dreadnomad/FGCCS-Ctrl22/README.md

# FGCCS-Ctrl22
Atmega4808-based charge controller for electric vehicles.
Inspired by SmartEVSE.
