dreadnomad/FGCCS-Ctrl22/doc/APPNOTES.md

# Useful Application Notes for ATmega4808 Development

All Application Notes for ATmega4808 available at:
https://www.microchip.com/wwwproducts/en/ATMEGA4808 -> Documents

- AN1982 Interrupt System
- AN8108 Temperature Sensor Calibration
- AN2751 Process Scheduling
- TB3209 Getting Started with ADC
- TB3217 Getting Started with TCA
- TB3214 Getting Started with TCB
- TB3217 Getting Started with USART
