dreadnomad/FGCCS-Ctrl22/circuit/parts_mouser.pdf

ATMEVSE
Mouser-Nr. | Herst.- Nr. | Hersteller Beschreibung | Stückzahl Preis (EUR) Gesamtpreis: (EUR)
926-LM7332MA/NOPB LM7332MA/NOPB | Texas Instruments Operationsverstärker DUAL RRIO OP AMP | 5 | 2,53 € | 12,65 €
579-TC7660SEOA | TC7660SEOA | Microchip Schaltspannungsregler High Voltage | 5 | 0,81 € | 4,05 €
595-SN65HVD72D | SN65HVD72D | Texas Instruments RS-485-IC-Schnittstelle 3.3V-Supply RS-485 | 5 | 2,50 € | 12,50 €
512-FAN3214TMX | FAN3214TMX | ON Semiconductor Gate-Treiber Dual 4A High-Speed LowSide Gate-Treiber | 5 | 1,06 € | 5,30 €
769-AQH1213AX | AQH1213AX | Panasonic Halbleiterrelais - PCB-Montage AC 600 V Zero Cross 0.6A SMD | 15 | 1,32 € | 19,80 €
621-AP5100WG-7 | AP5100WG-7 | Diodes Incorporated Schaltspannungsregler 1.2A Step-Down Conv 1.4MHz Sw Freq | 5 | 0,89 € | 4,46 €
849-CPC1114N | CPC1114N | IXYS | Halbleiterrelais - PCB-Montage SP, Normally-Closed OptoMOS Relay 10 | 0,95 € | 9,54 €
594-MCT06030C3309FP5MCT06030C3309FP500 Vishay | Dünnfilmwiderstände - SMD .1W 33ohm 1% 0603 50ppm Auto | 10 | 0,21 € | 2,07 €
594-MCT06030C2209FP5MCT06030C2209FP500 Vishay | Dünnfilmwiderstände - SMD .1W 22ohm 1% 0603 50ppm Auto | 30 | 0,21 € | 6,21 €
594-MCT06030C1202FP5MCT06030C1202FP500 Vishay | Dünnfilmwiderstände - SMD .1W 12Kohm 1% 0603 50ppm Auto | 10 | 0,14 € | 1,44 €
594-MCT06030C1001FP5MCT06030C1001FP500 Vishay | Dünnfilmwiderstände - SMD .1W 1Kohm 1% 0603 50ppm Auto | 20 | 0,09 € | 1,80 €
594-MCT06030C1502FP5MCT06030C1502FP500 Vishay | Dünnfilmwiderstände - SMD .1W 15Kohm 1% 0603 50ppm Auto | 40 | 0,14 € | 5,76 €
594-MCT06030C2001FP5MCT06030C2001FP500 Vishay | Dünnfilmwiderstände - SMD .1W 2Kohm 1% 0603 50ppm Auto | 20 | 0,14 € | 2,88 €
594-MCT06030C1003FP5MCT06030C1003FP500 Vishay | Dünnfilmwiderstände - SMD .1W 100Kohm 1% 0603 50ppm Auto | 10 | 0,13 € | 1,25 €
594-MCT06030C4022FP5MCT06030C4022FP500 Vishay | Dünnfilmwiderstände - SMD .1W 40.2Kohms 1% 0603 50ppm Auto | 10 | 0,09 € | 0,90 €
594-MCT06030C1000FP5MCT06030C1000FP500 Vishay | Dünnfilmwiderstände - SMD .1W 100ohm 1% 0603 50ppm Auto | 110 | 0,05 € | 5,94 €
594-MCT06030C1002FP5MCT06030C1002FP500 Vishay | Dünnfilmwiderstände - SMD .1W 10Kohms 1% 0603 50ppm Auto | 70 | 0,10 € | 6,93 €
594-MCT06030C3162FP5MCT06030C3162FP500 Vishay | Dünnfilmwiderstände - SMD .1W 31.6Kohms 1% 0603 50ppm | 20 | 0,14 € | 2,70 €
512-BSS138 | BSS138 | ON Semiconductor MOSFET SOT-23 N-CH LOGIC | 10 | 0,16 € | 1,61 €
810-MLF1608A3R3J | MLF1608A3R3J | TDK | Festinduktivitäten 0603 3.3uH 5% | 10 | 0,15 € | 1,48 €
710-61304011121 | 61304011121 | Wurth Elektronik Sockel & Kabelgehäuse WR-PHD 2.54mm Hdr 40P Single Str Gold | 2 | 1,31 € | 2,62 €
710-61300821121 | 61300821121 | Wurth Elektronik Sockel & Kabelgehäuse WR-PHD 2.54mm Hdr 8P Dual Str Gold | 20 | 0,50 € | 9,96 €
871-B72214S0271K551 B72214S0271K551 | EPCOS / TDKVaristoren 275VAC 10% 14mm StandarD | 15 | 0,46 € | 6,92 €
576-3921125000 | 39211250000 | Littelfuse Sicherungen mit Anschlüssen (Durchsteckmontage) 250V IEC TL LL 1.25A TE5 10 | 0,59 € | 5,89 €
576-1812L020PR | 1812L020PR | Littelfuse Rückstellbare Sicherungen - PPTC 30V 1812 .200A POLYFUSE | 10 | 0,33 € | 3,29 €
771-PMEG4010BEA,135PMEG4010BEA,135 | Nexperia Schottky Dioden & Gleichrichter 1A Very Low VF MEGA Barrier Rectifier5 | 0,32 € | 1,58 €

583-BAT54S | BAT54S | Rectron Schottky Dioden & Gleichrichter SOT23 0.2A 30V Schot tky Dblr | 25 | 0,08 € | 1,90 €
652-SMAJ13CA | SMAJ13CA | Bourns | ESD-Entstörer/TVS-Dioden 13volts 5uA 18.6 Amps Bi-Dir | 10 | 0,26 € | 2,63 €
833-MMXZ5226B-TP | MMXZ5226B-TP | Micro Commercial Components (MCC) Zener-Dioden 200mW 3.3V | 10 | 0,17 € | 1,67 €
963-EMK212ABJ106MG-TEMK212ABJ106MG-T | Taiyo YudenKondensator aus mehreren Keramikschichten MLCC - SMD/SMT 0805 16VDC 10uF 20% X5R 80 | 0,12 € | 9,44 €
963-EMF212B7104KGHTEMF212B7104KGHT | Taiyo YudenKondensator aus mehreren Keramikschichten MLCC - SMD/SMT 0805 16V 0.1uF 10% AEC-Q200 120 | 0,06 € | 7,32 €
77-VJ0805A271KXJPBC VJ0805A271KXJPW1BC Vishay | Kondensator aus mehreren Keramikschichten MLCC - SMD/SMT 0805 270pF 16volts C0G 10% 10 | 0,20 € | 1,98 €
77-VJ0805A102KXAAC VJ0805A102KXAAC | Vishay | Kondensator aus mehreren Keramikschichten MLCC - SMD/SMT 1000pF 50volts C0G 10% 10 | 0,09 € | 0,90 €
77-VJ805Y105KXARW1BCVJ0805Y105KXARW1BC Vishay | Kondensator aus mehreren Keramikschichten MLCC - SMD/SMT FACTORY NOT ACCEPTING ORDERS 10 | 0,27 € | 2,70 €
77-VJ0805Y101KXACBC VJ0805Y101KXACW1BC Vishay | Kondensator aus mehreren Keramikschichten MLCC - SMD/SMT 0805 100pF 50volts X7R 10% 10 | 0,22 € | 2,16 €
871-B41231A4109M000B41231A4109M000 | EPCOS / TDKAlu-Elektrolytkondensatoren - einrastend 16VDC 10000uF 20% PVC 6mm Terminals 10 | 1,04 € | 10,40 €
709-IRM10-12 | IRM-10-12 | MEAN WELLAC/DC-Leistungsmodule 12V 0.85A 10.2W 85-264Vin Encap PS | 5 | 7,70 € | 38,50 €
490-TB005-762-10BE TB005-762-10BE | CUI DevicesFeste Anschlussblöcke Terminal block, screw type, 7.62 , horizontal, 10 poles, CUI Blue, slotted screw, PCB mount 10 | 1,55 € | 15,50 €
490-TB004-508-18BE TB004-508-18BE | CUI DevicesFeste Anschlussblöcke Terminal block, screw type, 5.08 , horizontal, 18 poles, CUI Blue, slotted screw, PCB mount 10 | 1,68 € | 16,80 €
581-TLCR107M006RTA TLCR107M006RTA | AVX | Tantalkondensatoren - fest für SMD 6.3V 100uF 20% | 10 | 1,94 € | 19,40 €
| | | | | TOTAL: | 270,82 €
