dreadnomad/FGCCS-Ctrl22/circuit/FGCCS-Ctrl22-Materialstueckliste.xls

FGCCS-CTRL22-REV1.1
Materialstückliste
Herst.- Nr. | Hersteller | Beschreibung | Stückzahl | Stückkosten | Gesamtpreis
ATMEGA4808-XFR | Microchip | 8-Bit Mikrocontroller - MCU 20MHz, 48KB, SOIC | 1 | 1.08 € | 1.08 €
ESP32-WROOM-32D(M113DH3200PH3Q0) | Espressif | WLAN-Module (802.11) SMD Module, ESP32-D0WD, 32Mbits SPI flash, UART mode, PCB antenna | 1 | 3.22 € | 3.22 €
LM7332MA/NOPB | Texas Instruments | Dualer Operationsverstärker | 1 | 2.40 € | 2.40 €
TC7660SEOA | Microchip | 12V Schaltspannungsregler/Inverter | 1 | 0.76 € | 0.76 €
SN65HVD72D | Texas Instruments | RS-485-IC-Schnittstelle | 1 | 2.35 € | 2.35 €
FAN3214TMX | ON Semiconductor | Zweikanal 4A Gate-Treiber | 1 | 1.00 € | 1.00 €
AQH1213AX | Panasonic | Halbleiterrelais - AC 600 V | 3 | 1.32 € | 3.96 €
AP5100WG-7 | Diodes Incorporated | 3.3V Schaltspannungsregler 1.2A Step-Down | 1 | 0.85 € | 0.86 €
CPC1114N | IXYS | Halbleiterrelais - Öffner OptoMOS Relay | 2 | 1.13 € | 2.26 €
MCT06030C2209FP500 | Vishay | 22 Ohm, 100mW, 1%, SMD 0603 Widerstand | 3 | 0.20 € | 0.59 €
MCT06030C1202FP500 | Vishay | 12k Ohm, 125mW, 1%, SMD 0603 Widerstand | 1 | 0.14 € | 0.14 €
MCT06030C1001FP500 | Vishay | 1k Ohm, 100mW, 1%, SMD 0603 Widerstand | 6 | 0.09 € | 0.51 €
MCT06030C1502FP500 | Vishay | 15k Ohm, 100mW, 1%, SMD 0603 Widerstand | 4 | 0.14 € | 0.54 €
MCT06030C2001FP500 | Vishay | 2k Ohm, 100mW, 1%, SMD 0603 Widerstand | 2 | 0.14 € | 0.27 €
MCT06030C1003FP500 | Vishay | 100k Ohm, 100mW, 1%, SMD 0603 Widerstand | 1 | 0.13 € | 0.13 €
MCT06030C4022FP500 | Vishay | 40.2k Ohm, 100mW, 1%, SMD 0603 Widerstand | 1 | 0.09 € | 0.09 €
MCT06030C1000FP500 | Vishay | 100 Ohm, 100mW, 1%, SMD 0603 Widerstand | 10 | 0.14 € | 1.36 €
MCT06030C1002FP500 | Vishay | 10k Ohm, 100mW, 1%, SMD 0603 Widerstand | 7 | 0.14 € | 0.95 €
MCT06030C3162FP500 | Vishay | 31.6k Ohm, 100mW, 1%, SMD 0603 Widerstand | 2 | 0.13 € | 0.25 €
BSS138 | ON Semiconductor | Logik-Mosfet, SOT23 | 1 | 0.22 € | 0.22 €
61304011121 | Wurth Elektronik | Stiftleiste, 2.54mm, 1x40 Pins | 1 | 1.31 € | 1.31 €
B72214S0271K551 | EPCOS / TDK | Varistor 275VAC 10% 14mm | 3 | 0.53 € | 1.60 €
39211250000 | Littelfuse | Sicherung Träge 250V 1.25A | 1 | 0.74 € | 0.75 €
1812L020PR | Littelfuse | Rückstellende Sicherung, 0.2 A, SMD 1812 | 1 | 0.37 € | 0.37 €
PMEG4010BEA,135 | Nexperia | Gleichrichterdiode 1A | 1 | 0.30 € | 0.30 €
BAT54S | Rectron | Duale Schottky-Diode, 0.2A, 30V, SOT23 | 9 | 0.11 € | 0.97 €
SMAJ13CA | Bourns | ESD-Entstörer/TVS-Diode 13volts 5uA | 1 | 0.32 € | 0.32 €
EMK212ABJ106MG-T | Taiyo Yuden | 10uF/16V, 20%, SMD 0805 Keramikkondensator | 8 | 0.16 € | 1.29 €
EMF212B7104KGHT | Taiyo Yuden | 100nF, 10%, SMD 0805 Keramikkondensator | 12 | 0.09 € | 1.03 €
VJ0805A271KXJPW1BC | Vishay | 270pF/16V, 10%, SMD 0805 Keramikkondensator | 1 | 0.19 € | 0.19 €
VJ0805A102KXAAC | Vishay | 1nF/50V, 10%, SMD 0805 Keramikkondensator | 1 | 0.09 € | 0.09 €
VJ0805Y105KXARW1BC | Vishay | 1uF, 10%, SMD 0805 Keramikkondensator | 1 | 0.25 € | 0.25 €
VJ0805Y101KXACW1BC | Vishay | 100pF/50V, 10%, SMD 0805 Keramikkondensator | 1 | 0.20 € | 0.20 €
TLCR107M006RTA | AVX | 100uF/6.3V, 20%, SMD 0805 Tantalkondensator | 1 | 2.25 € | 2.25 €
B41231A4109M000 | EPCOS / TDK | 10000uF/16V, 20%, 6mm Raster Alu-Elektrolytkondensator | 1 | 1.24 € | 1.24 €
LQH32CN1R0M23L | Murata | 1uH, 20%, 800mA, SMD 1210 Festinduktivität | 1 | 0.29 € | 0.29 €
IRM-10-12 | MEAN WELL | AC/DC-Schaltnetzteil 12V 0.85A 10.2W 85-264V | 1 | 7.25 € | 7.25 €
TB005-762-05BE | CUI Devices | Schraubterminal, 7.62mm Raster, 5-polig | 2 | 1.35 € | 2.70 €
TB004-508-09BE | CUI Devices | Schraubterminal, 5.08mm Raster, 9-polig | 2 | 1.47 € | 2.94 €
61200821621 | Wurth Elektronik | Stiftleiste, 2.54mm, 2x4 Pins, verpolungssicher | 1 | 0.93 € | 0.93 €
61200823021 | Wurth Elektronik | IDC-Stecker, 2.54mm, 2x4 Pins, verpolungssicher | 1 | 1.69 € | 1.69 €
 |  |  |  | TOTAL: | 50.90 €
