dreadnomad/FGCCS-Ctrl22/circuit/FGCCS-Schaltplan-Rev1-1.pdf

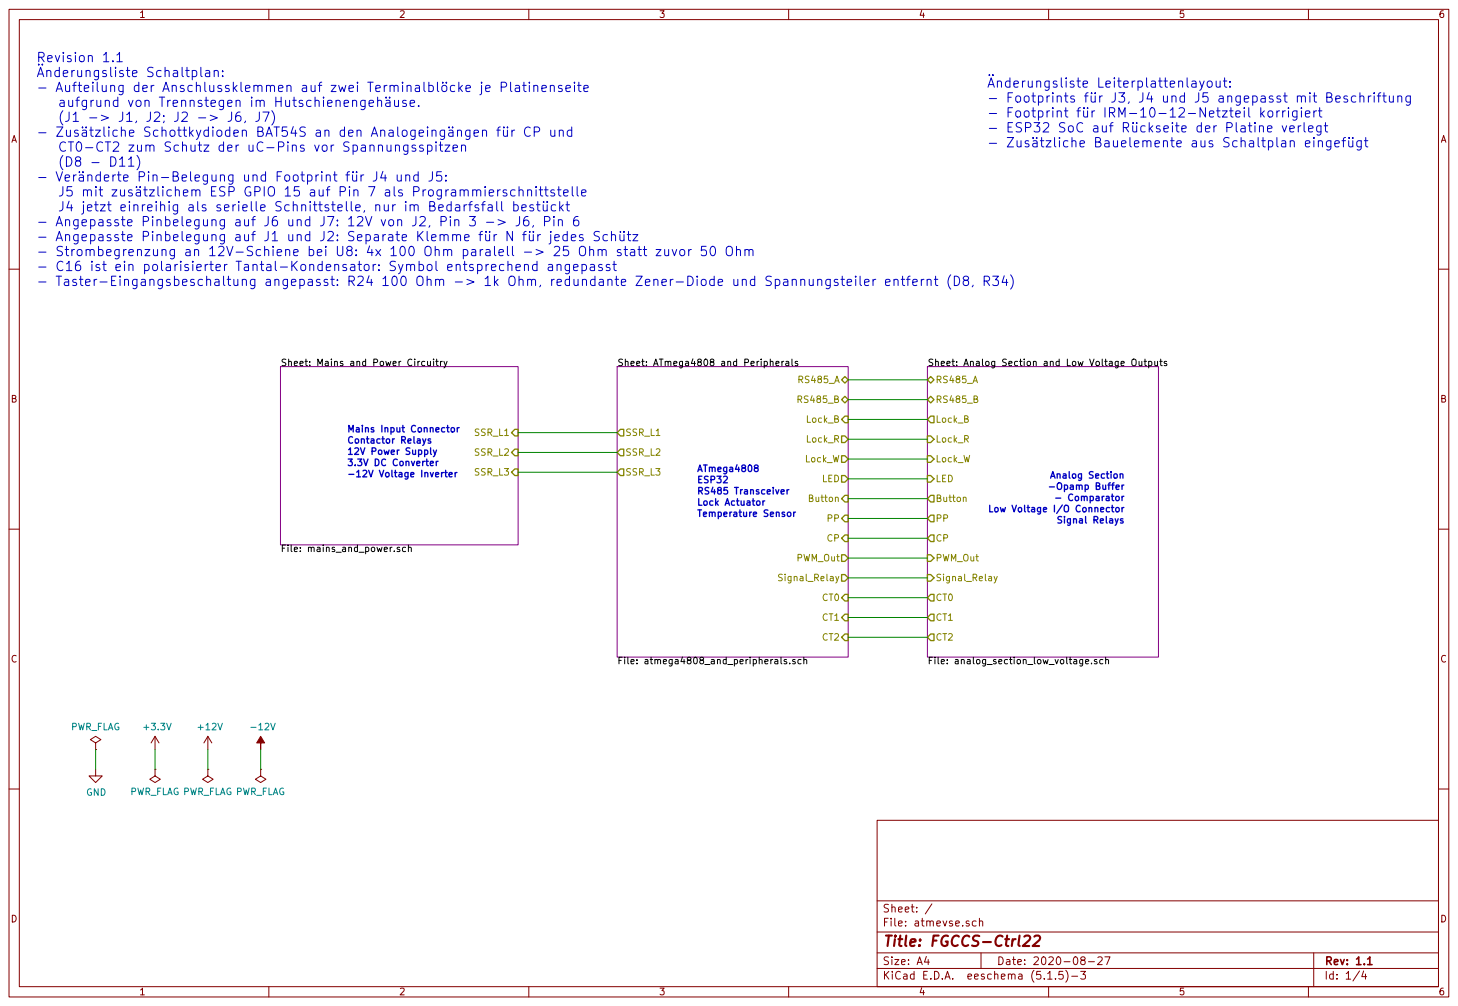
[picture p9: page 1]

Revision 1.1
Änderungsliste Schaltplan:
- Aufteilung der Anschlussklemmen auf zwei Terminalblöcke je Platinenseite
aufgrund von Trennstegen im Hutschienengehäuse.
- Zusätzliche Schottkydioden BAT54S an den Analogeingängen für CP und
CT0-CT2 zum Schutz der uC-Pins vor Spannungsspitzen
- Veränderte Pin-Belegung und Footprint für J4 und J5:
J5 mit zusätzlichem ESP GPIO 15 auf Pin 7 als Programmierschnittstelle
J4 jetzt einreihig als serielle Schnittstelle, nur im Bedarfsfall bestückt
- Angepasste Pinbelegung auf J6 und J7: 12V von J2, Pin 3 -> J6, Pin 6
- Angepasste Pinbelegung auf J1 und J2: Separate Klemme für N für jedes Schütz
- Strombegrenzung an 12V-Schiene bei U8: 4x 100 Ohm paralell -> 25 Ohm statt zuvor 50 Ohm
- C16 ist ein polarisierter Tantal-Kondensator: Symbol entsprechend angepasst
- Taster-Eingangsbeschaltung angepasst: R24 100 Ohm -> 1k Ohm, redundante Zener-Diode und Spannungsteiler entfernt (D8, R34)

Änderungsliste Leiterplattenlayout:
- Footprints für J3, J4 und J5 angepasst mit Beschriftung
- Footprint für IRM-10-12-Netzteil korrigiert
- ESP32 SoC auf Rückseite der Platine verlegt
- Zusätzliche Bauelemente aus Schaltplan eingefügt

Sheet: Mains and Power Circuitry

Sheet: Analog Section and Low Voltage Outputs

ATmega4808 ESP32 RS485 Transceiver Lock Actuator Temperature Sensor

File: atmevse.sch Sheet: /
Id: 1/4 Title: FGCCS-Ctrl22

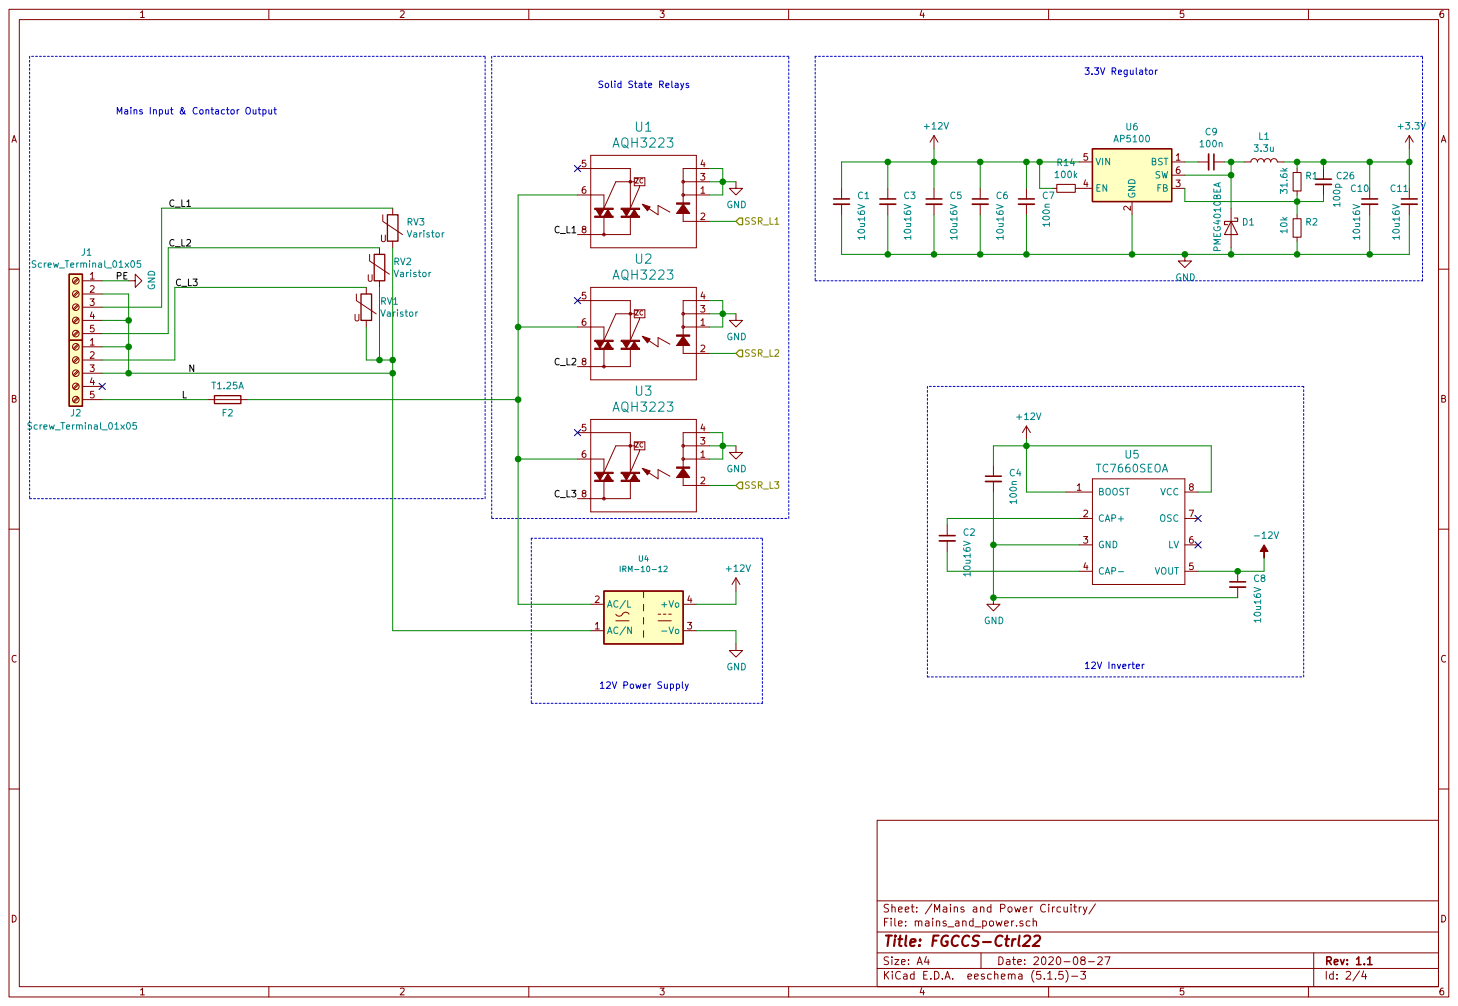
[picture p10: page 2]

Mains Input & Contactor Output

2 FB 3 EN 4 VIN 5 SW 6 U6 AP5100 F2 T1.25A C9

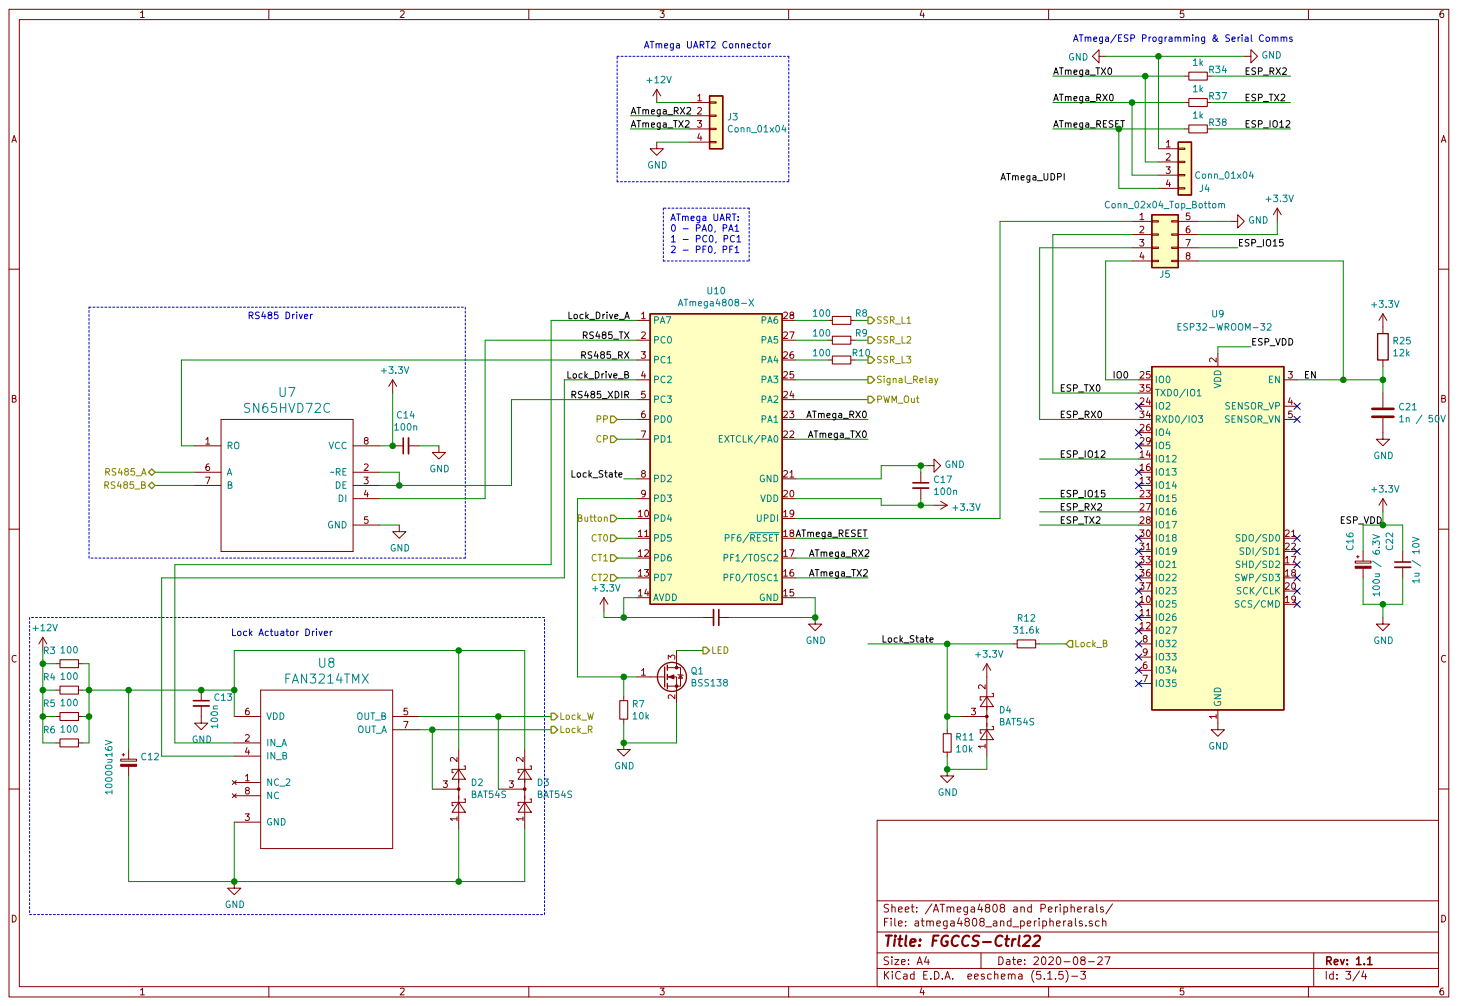
[picture p11: page 3]

2 SCK/CLK 20 SDO/SD0 21 SDI/SD1 22

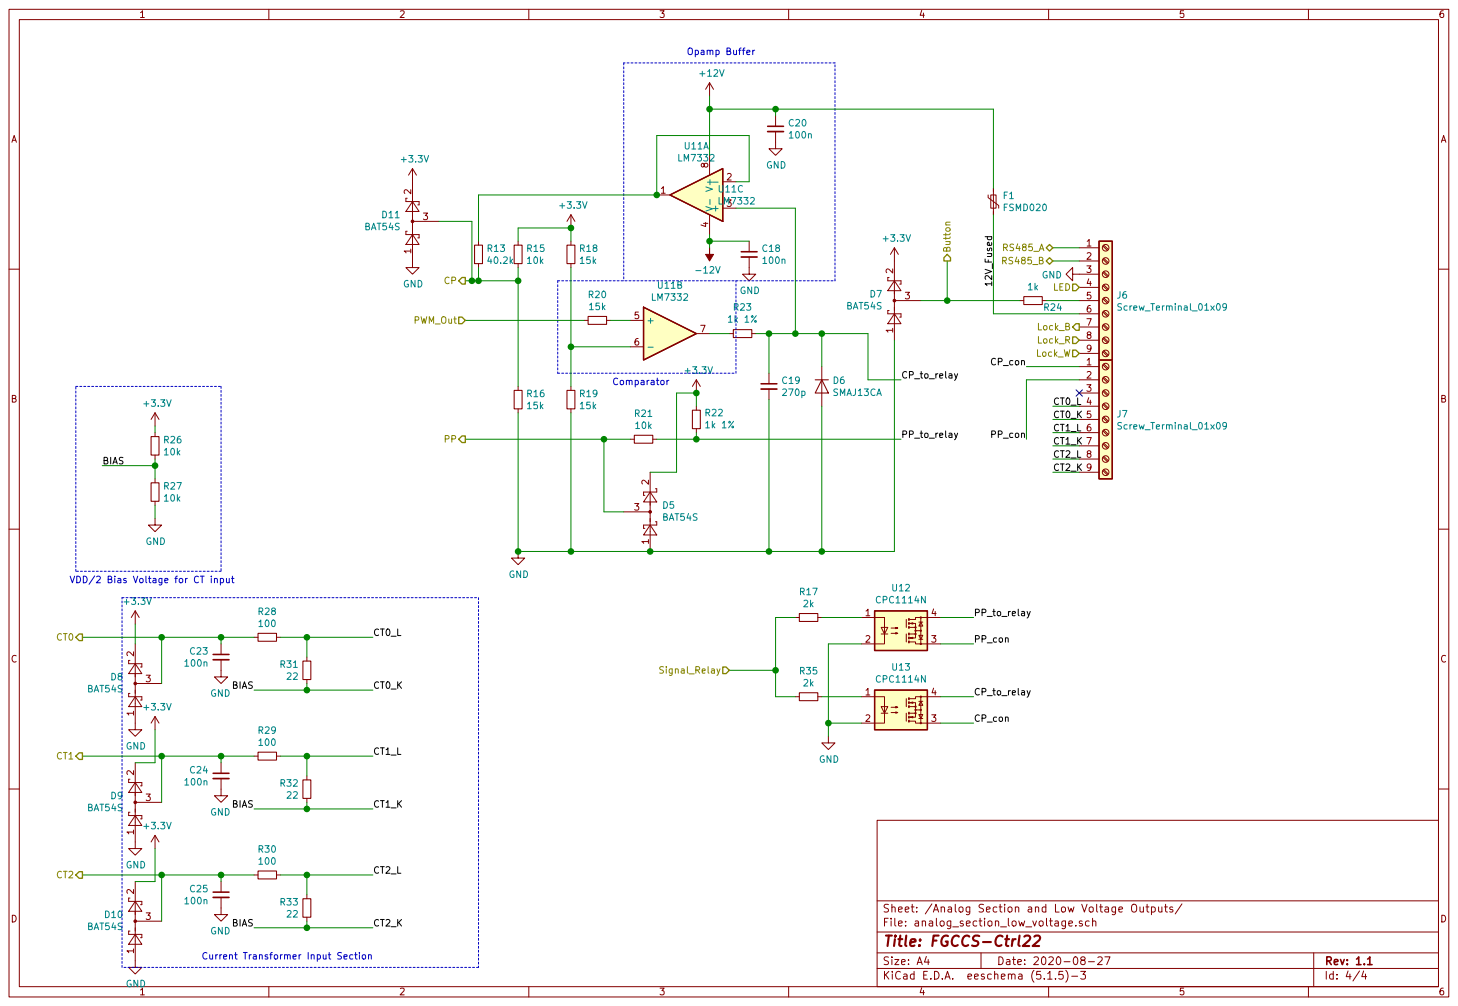
[picture p12: page 4]

1 2 D8 3 BAT54S GND
VDD/2 Bias Voltage for CT input

Sheet: /Analog Section and Low Voltage Outputs/
File: analog_section_low_voltage.sch
Id: 4/4 Title: FGCCS-Ctrl22
