dreadnomad/FGCCS-Ctrl22/circuit/fgccs-ctrl22.kicad_pcb

## KiCad design circuit/fgccs-ctrl22.kicad_pcb (2020-08-27)

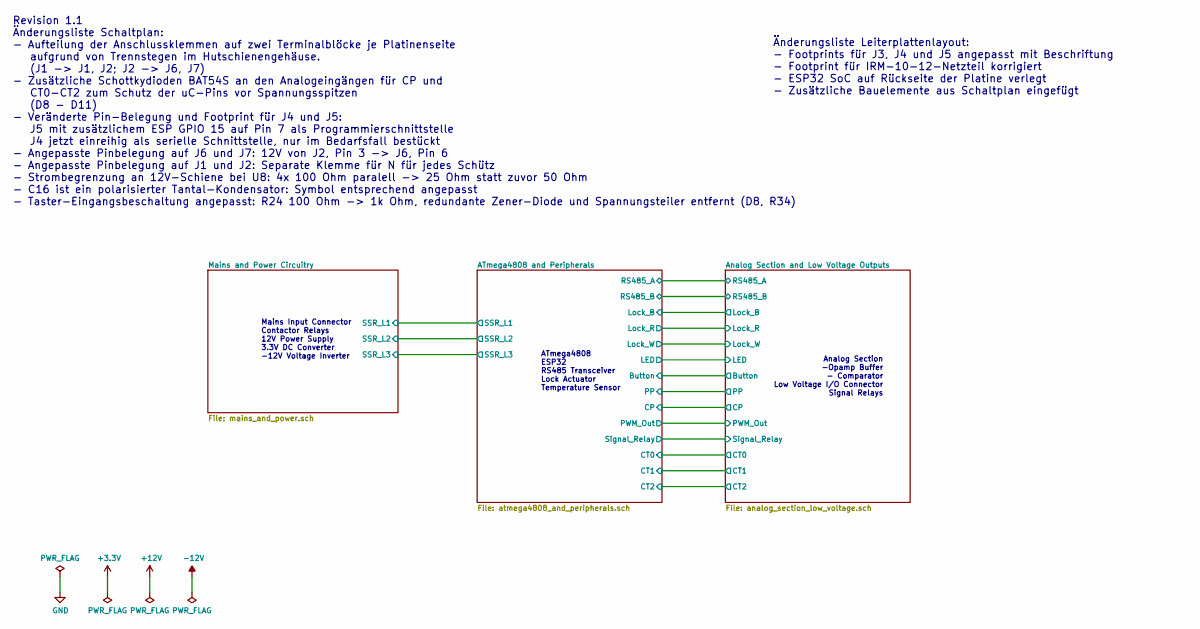
[picture p13: schematic fgccs-ctrl22.sch]

Notes on the sheet:
Mains Input Connector Contactor Relays 12V Power Supply 3.3V DC Converter -12V Voltage Inverter
ATmega4808 ESP32 RS485 Transceiver Lock Actuator Temperature Sensor
Analog Section -Opamp Buffer - Comparator Low Voltage I/O Connector Signal Relays
Revision 1.1 Änderungsliste Schaltplan: - Aufteilung der Anschlussklemmen auf zwei Terminalblöcke je Platinenseite aufgrund von Trennstegen im Hutschienengehäuse. (J1 -> J1, J2; J2 -> J6, J7) - Zusätzliche Schottkydioden BAT54S an den Analogeingängen für CP und CT0-CT2 zum Schutz der uC-Pins vor Sp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
Änderungsliste Leiterplattenlayout: - Footprints für J3, J4 und J5 angepasst mit Beschriftung - Footprint für IRM-10-12-Netzteil korrigiert - ESP32 SoC auf Rückseite der Platine verlegt - Zusätzliche Bauelemente aus Schaltplan eingefügt

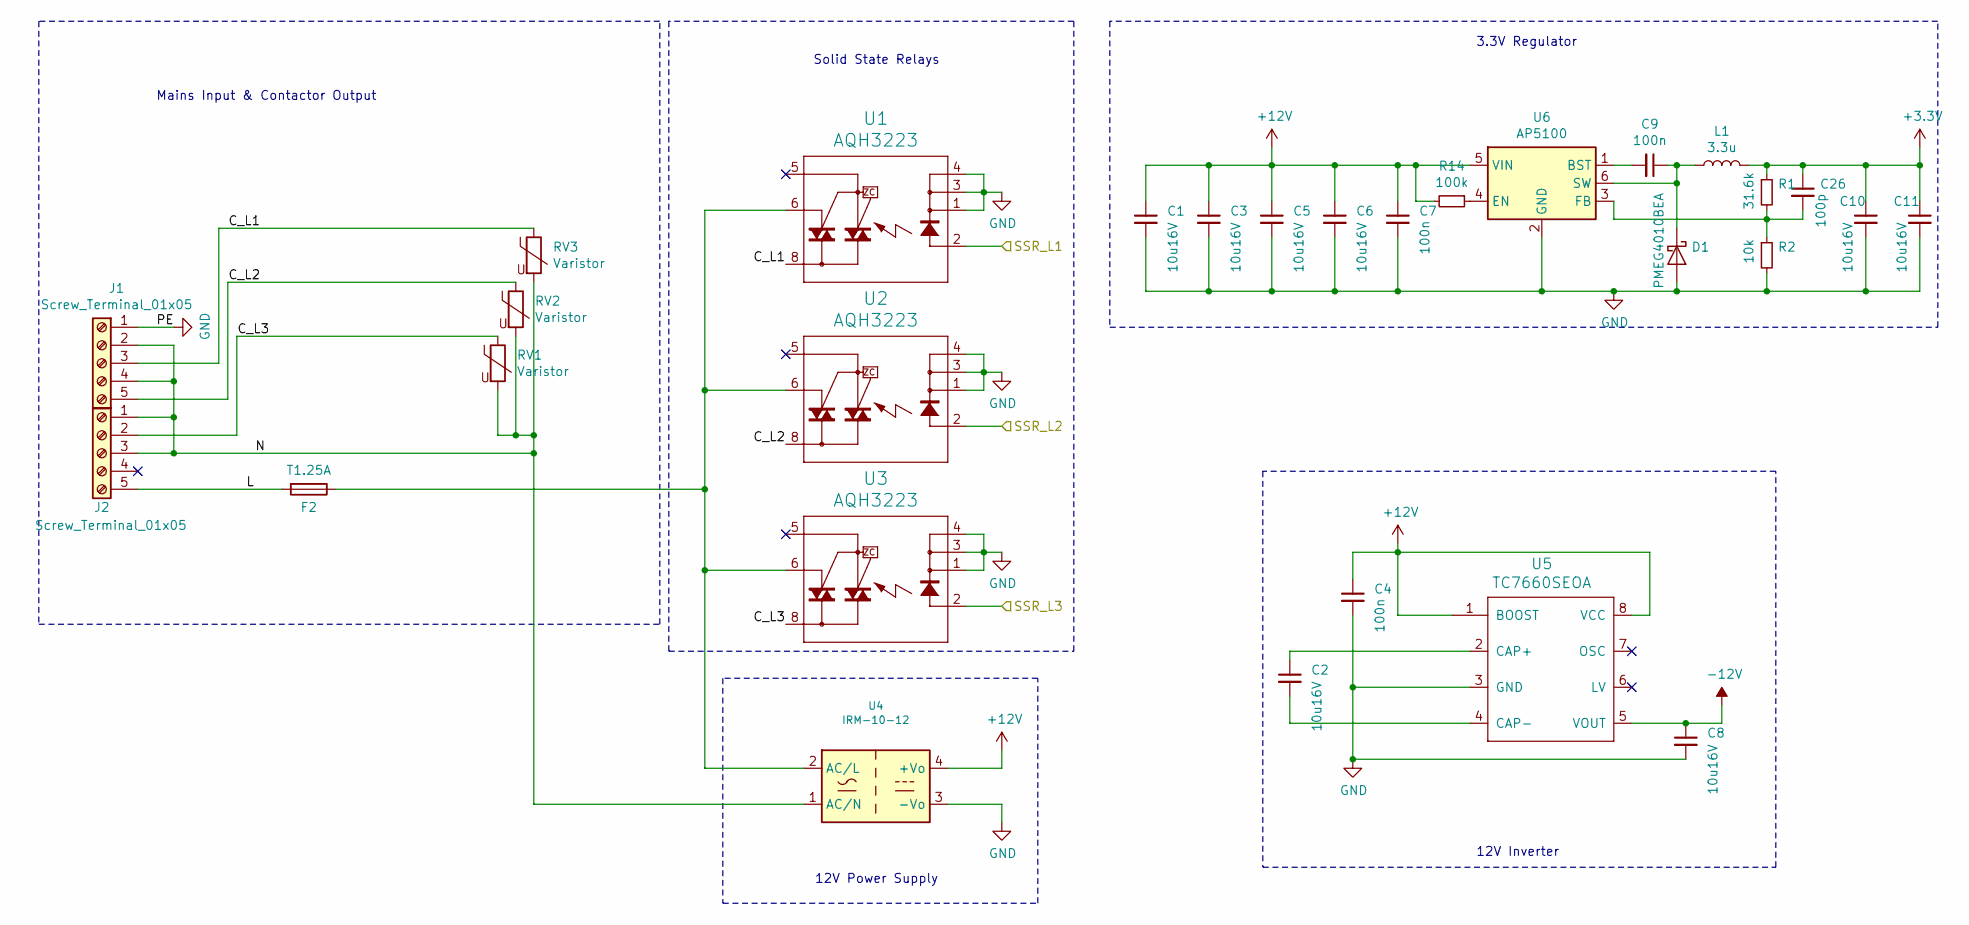
[picture p14: schematic mains_and_power.sch, FGCCS-Ctrl22]

Parts:
C1, C2, C3, C5, C6, C8, C10, C11: 10u16V; C_0805_2012Metric_Pad1.15x1.40mm_HandSolder; PartNo 963-EMK212ABJ106MG-T
C4, C7, C9: 100n; C_0805_2012Metric_Pad1.15x1.40mm_HandSolder; PartNo 963-EMF212B7104KGHT
C26: 100p; C_0805_2012Metric_Pad1.15x1.40mm_HandSolder; PartNo 77-VJ0805Y101KXACBC
D1: PMEG4010BEA; D_SOD-323_HandSoldering; PartNo 771-PMEG4010BEA,135
F2: T1.25A; TE5; PartNo 576-3921125000
J1: Screw_Terminal_01x05; hv_screw_5pin_1
J2: Screw_Terminal_01x05; hv_screw_5pin_2
L1: 3.3u; L_1210_3225Metric_Pad1.42x2.65mm_HandSolder; PartNo 810-MLF1608A3R3J
R1: 31.6k; R_0603_1608Metric_Pad1.05x0.95mm_HandSolder; PartNo 594-MCT06030C3162FP5
R2: 10k; R_0603_1608Metric_Pad1.05x0.95mm_HandSolder; PartNo 594-MCT06030C1002FP5
R14: 100k; R_0603_1608Metric_Pad1.05x0.95mm_HandSolder; PartNo 594-MCT06030C1003FP5
RV1, RV2, RV3: Varistor; RV_Disc_D15.5mm_W5mm_P7.5mm; PartNo 871-B72214S0271K551
U1, U2, U3: AQH3223; DIL07SMD; PartNo 769-AQH1213AX
U4: IRM-10-12; Converter_ACDC_MeanWell_IRM-10-xx_THT; PartNo 709-IRM10-12
U5: TC7660SEOA; SOIC-8_3.9x4.9mm_P1.27mm; PartNo 579-TC7660SEOA
U6: AP5100; SOT-23-6; PartNo 621-AP5100WG-7

Connections:
+3V3: C10.1, C11.1, C26.1, L1.2, R1.1; also elsewhere on the board
+12V: C1.1, C3.1, C4.1, C5.1, C6.1, C7.1, R14.2, U4.4 (+Vo), U5.1 (BOOST), U5.8 (VCC), U6.5 (VIN); also elsewhere on the board
-12V: C8.1, U5.5 (VOUT); also elsewhere on the board
/ATmega4808 and Peripherals/SSR_L1: U1.2 (A); also elsewhere on the board
/ATmega4808 and Peripherals/SSR_L2: U2.2 (A); also elsewhere on the board
/ATmega4808 and Peripherals/SSR_L3: U3.2 (A); also elsewhere on the board
/Mains and Power Circuitry/C_L1: J1.3, RV3.1, U1.8 (DS1)
/Mains and Power Circuitry/C_L2: J1.5, RV2.1, U2.8 (DS1)
/Mains and Power Circuitry/C_L3: J2.2, RV1.1, U3.8 (DS1)
/Mains and Power Circuitry/L: F2.2, J2.5
/Mains and Power Circuitry/N: J1.2, J1.4, J2.1, J2.3, RV1.2, RV2.2, RV3.2, U4.1 (AC/N)
GND: C1.2, C3.2, C4.2, C5.2, C6.2, C7.2, C8.2, C10.2, C11.2, D1.2 (A), J1.1, R2.2, U1.1 (K), U1.3 (K1), U1.4 (K2), U2.1 (K), U2.3 (K1), U2.4 (K2), U3.1 (K), U3.3 (K1), U3.4 (K2), U4.3 (-Vo), U5.3 (GND), U6.2 (GND); also elsewhere on the board
unnamed: C2.1, U5.2 (CAP+)
unnamed: C2.2, U5.4 (CAP-)
unnamed: C9.1, D1.1 (K), L1.1, U6.6 (SW)
unnamed: C9.2, U6.1 (BST)
unnamed: C26.2, R1.2, R2.1, U6.3 (FB)
unnamed: F2.1, U1.6 (DS3), U2.6 (DS3), U3.6 (DS3), U4.2 (AC/L)
unnamed: R14.1, U6.4 (EN)

Notes on the sheet:
Solid State Relays
Mains Input & Contactor Output
12V Power Supply
3.3V Regulator
12V Inverter

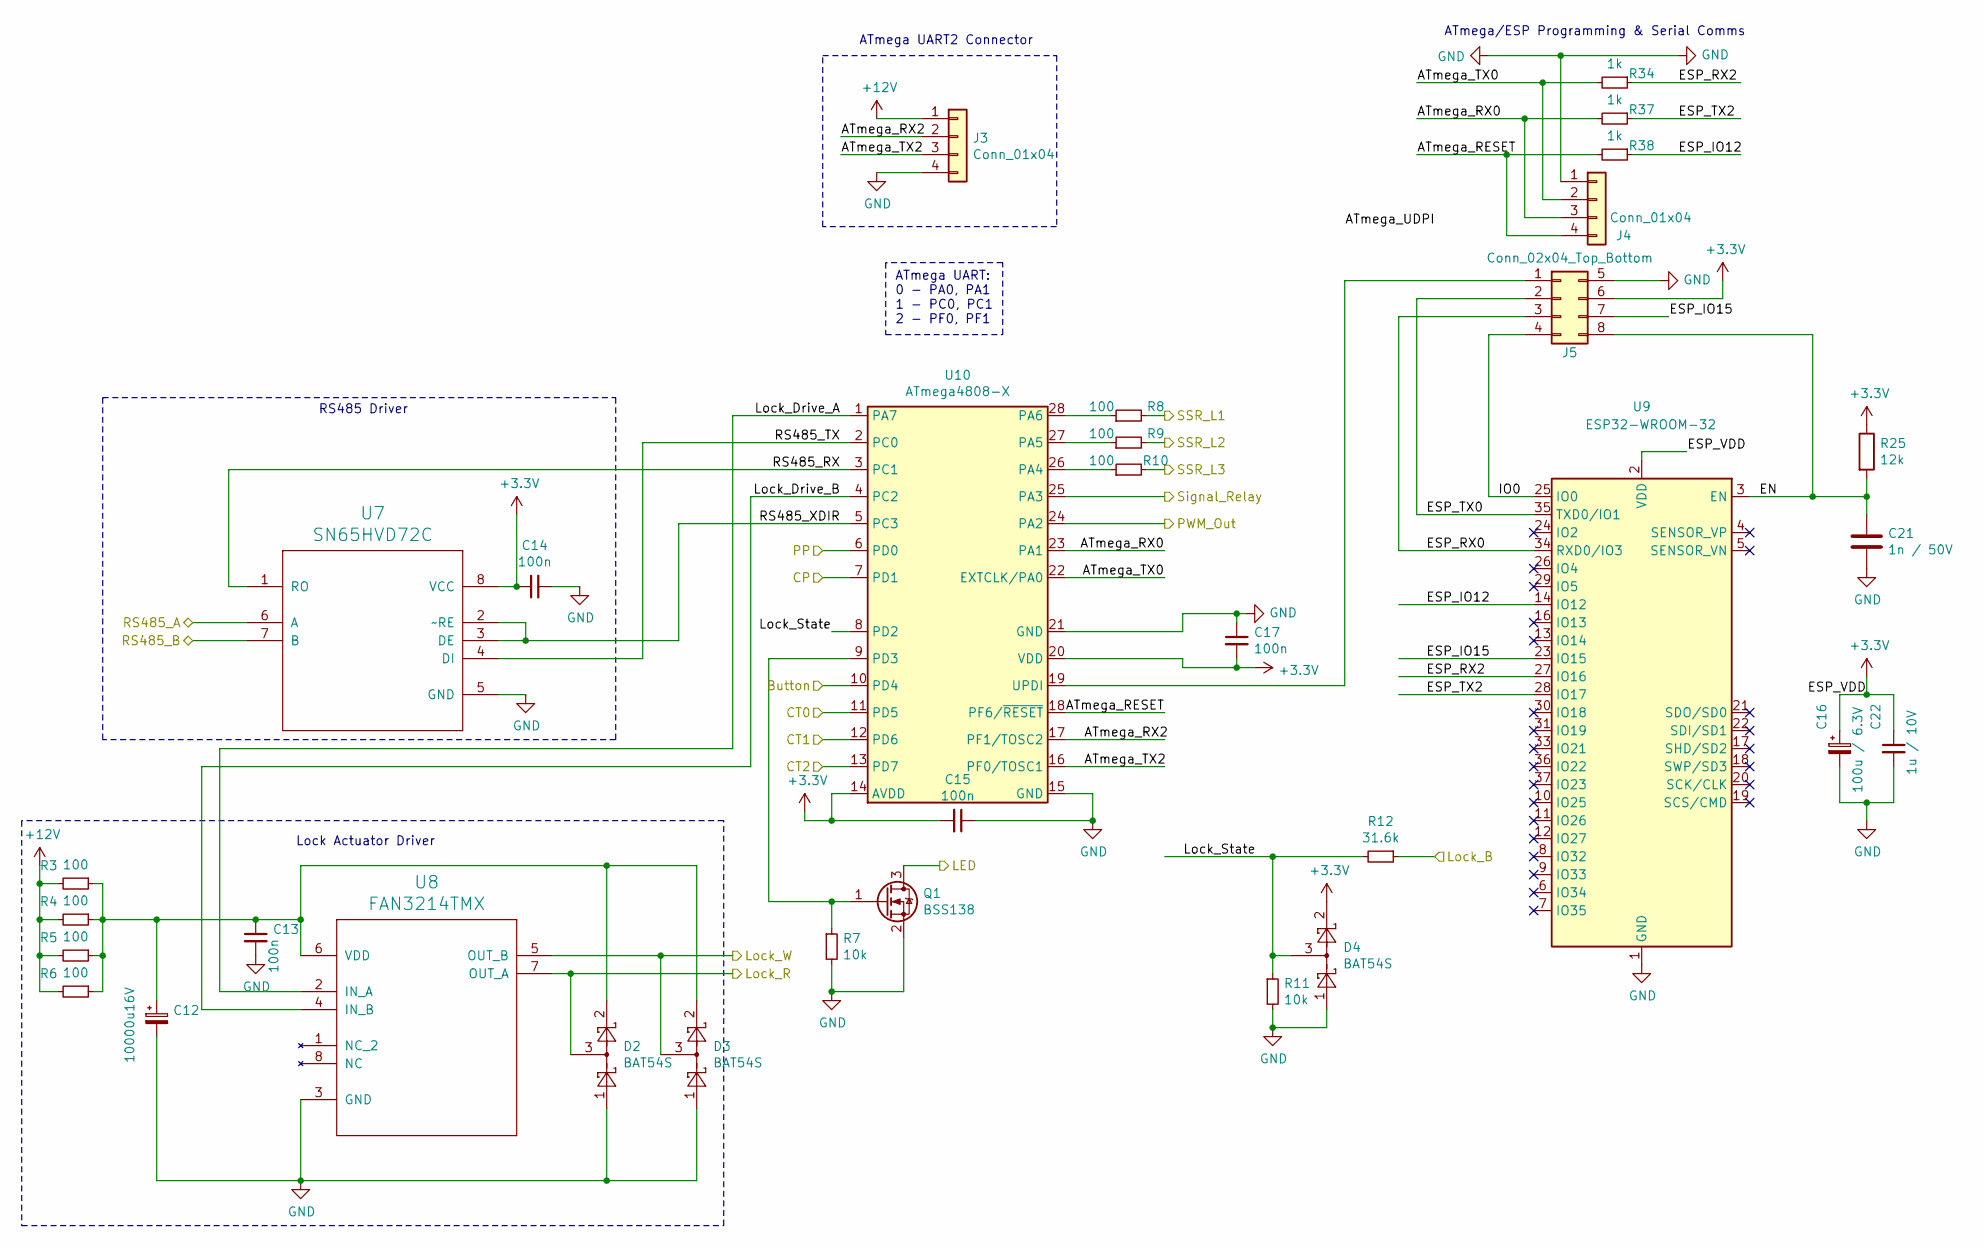
[picture p15: schematic atmega4808_and_peripherals.sch, FGCCS-Ctrl22]

Parts:
C12: 10000u16V; CP_Radial_D22.0mm_P10.00mm_SnapIn; PartNo 871-B41231A4109M000
C13, C14, C15, C17: 100n; C_0805_2012Metric_Pad1.15x1.40mm_HandSolder; PartNo 963-EMF212B7104KGHT
C16: 100u / 6.3V; CP_EIA-2012-15_AVX-P_Pad1.30x1.05mm_HandSolder; PartNo 581-TLCR107M006RTA
C21: 1n / 50V; C_0805_2012Metric_Pad1.15x1.40mm_HandSolder; PartNo 77-VJ0805A102KXAAC
C22: 1u / 10V; C_0805_2012Metric_Pad1.15x1.40mm_HandSolder; PartNo 77-VJ805Y105KXARW1BC
D2, D3, D4: BAT54S; SOT-23_Handsoldering; PartNo 583-BAT54S
J3: Conn_01x04; UART2-Header; PartNo 710-61304011121
J4: Conn_01x04; UART0-Header
J5: Conn_02x04_Top_Bottom; PROGRAM-Header; PartNo 710-61300821121
Q1: BSS138; SOT-23_Handsoldering; PartNo 512-BSS138
R3, R4, R5, R6, R8, R9, R10: 100; R_0603_1608Metric_Pad1.05x0.95mm_HandSolder; PartNo 594-MCT06030C1000FP5
R7, R11: 10k; R_0603_1608Metric_Pad1.05x0.95mm_HandSolder; PartNo 594-MCT06030C1002FP5
R12: 31.6k; R_0603_1608Metric_Pad1.05x0.95mm_HandSolder; PartNo 594-MCT06030C3162FP5
R25: 12k; R_0603_1608Metric_Pad1.05x0.95mm_HandSolder; PartNo 594-MCT06030C1202FP5
R34, R37, R38: 1k; R_0603_1608Metric_Pad1.05x0.95mm_HandSolder
U7: SN65HVD72C; SOIC-8_3.9x4.9mm_P1.27mm; PartNo 595-SN65HVD72D
U8: FAN3214TMX; SOIC-8_3.9x4.9mm_P1.27mm; PartNo 512-FAN3214TMX
U9: ESP32-WROOM-32
U10: ATmega4808-X; SSOP-28_5.3x10.2mm_P0.65mm

Connections:
+3V3: C14.1, C15.2, C16.1, C17.2, C22.1, D4.2, J5.6, R25.1, U7.8 (VCC), U9.2 (VDD), U10.14 (AVDD), U10.20 (VDD); also elsewhere on the board
+12V: J3.1, R3.2, R4.2, R5.2, R6.2; also elsewhere on the board
/ATmega4808 and Peripherals/ATmega_RESET: J4.4, R38.2, U10.18 (PF6/~RESET)
/ATmega4808 and Peripherals/ATmega_RX0: J4.3, R37.2, U10.23 (PA1)
/ATmega4808 and Peripherals/ATmega_RX2: J3.2, U10.17 (PF1/TOSC2)
/ATmega4808 and Peripherals/ATmega_TX0: J4.2, R34.2, U10.22 (EXTCLK/PA0)
/ATmega4808 and Peripherals/ATmega_TX2: J3.3, U10.16 (PF0/TOSC1)
/ATmega4808 and Peripherals/Button: U10.10 (PD4); also elsewhere on the board
/ATmega4808 and Peripherals/CP: U10.7 (PD1); also elsewhere on the board
/ATmega4808 and Peripherals/CT0: U10.11 (PD5); also elsewhere on the board
/ATmega4808 and Peripherals/CT1: U10.12 (PD6); also elsewhere on the board
/ATmega4808 and Peripherals/CT2: U10.13 (PD7); also elsewhere on the board
/ATmega4808 and Peripherals/EN: C21.1, J5.8, R25.2, U9.3 (EN)
/ATmega4808 and Peripherals/ESP_IO12: R38.1, U9.14 (IO12)
/ATmega4808 and Peripherals/ESP_IO15: J5.7, U9.23 (IO15)
/ATmega4808 and Peripherals/ESP_RX0: J5.3, U9.34 (RXD0/IO3)
/ATmega4808 and Peripherals/ESP_RX2: R34.1, U9.27 (IO16)
/ATmega4808 and Peripherals/ESP_TX0: J5.2, U9.35 (TXD0/IO1)
/ATmega4808 and Peripherals/ESP_TX2: R37.1, U9.28 (IO17)
/ATmega4808 and Peripherals/IO0: J5.4, U9.25 (IO0)
/ATmega4808 and Peripherals/LED: Q1.3 (D); also elsewhere on the board
/ATmega4808 and Peripherals/Lock_B: R12.1; also elsewhere on the board
/ATmega4808 and Peripherals/Lock_Drive_A: U8.2 (IN_A), U10.1 (PA7)
/ATmega4808 and Peripherals/Lock_Drive_B: U8.4 (IN_B), U10.4 (PC2)
/ATmega4808 and Peripherals/Lock_R: D2.3, U8.7 (OUT_A); also elsewhere on the board
/ATmega4808 and Peripherals/Lock_State: D4.3, R11.1, R12.2, U10.8 (PD2)
/ATmega4808 and Peripherals/Lock_W: D3.3, U8.5 (OUT_B); also elsewhere on the board
/ATmega4808 and Peripherals/PP: U10.6 (PD0); also elsewhere on the board
/ATmega4808 and Peripherals/PWM_Out: U10.24 (PA2); also elsewhere on the board
/ATmega4808 and Peripherals/RS485_A: U7.6 (A); also elsewhere on the board
/ATmega4808 and Peripherals/RS485_B: U7.7 (B); also elsewhere on the board
/ATmega4808 and Peripherals/RS485_RX: U7.1 (RO), U10.3 (PC1)
/ATmega4808 and Peripherals/RS485_TX: U7.4 (DI), U10.2 (PC0)
/ATmega4808 and Peripherals/RS485_XDIR: U7.2 (~~RE), U7.3 (DE), U10.5 (PC3)
/ATmega4808 and Peripherals/SSR_L1: R8.2; also elsewhere on the board
/ATmega4808 and Peripherals/SSR_L2: R9.2; also elsewhere on the board
/ATmega4808 and Peripherals/SSR_L3: R10.2; also elsewhere on the board
/ATmega4808 and Peripherals/Signal_Relay: U10.25 (PA3); also elsewhere on the board
GND: C12.2, C13.2, C14.2, C15.1, C16.2, C17.1, C21.2, C22.2, D2.1, D3.1, D4.1, J3.4, J4.1, J5.5, Q1.2 (S), R7.2, R11.2, U7.5 (GND), U8.3 (GND), U9.1 (GND), U9.15 (GND), U9.38 (GND), U9.39 (GND), U10.15 (GND), U10.21 (GND); also elsewhere on the board
unnamed: C12.1, C13.1, D2.2, D3.2, R3.1, R4.1, R5.1, R6.1, U8.6 (VDD)
unnamed: J5.1, U10.19 (UPDI)
unnamed: Q1.1 (G), R7.1, U10.9 (PD3)
unnamed: R8.1, U10.28 (PA6)
unnamed: R9.1, U10.27 (PA5)
unnamed: R10.1, U10.26 (PA4)

Notes on the sheet:
RS485 Driver
Lock Actuator Driver
ATmega/ESP Programming & Serial Comms
ATmega UART: 0 - PA0, PA1 1 - PC0, PC1 2 - PF0, PF1
ATmega UART2 Connector

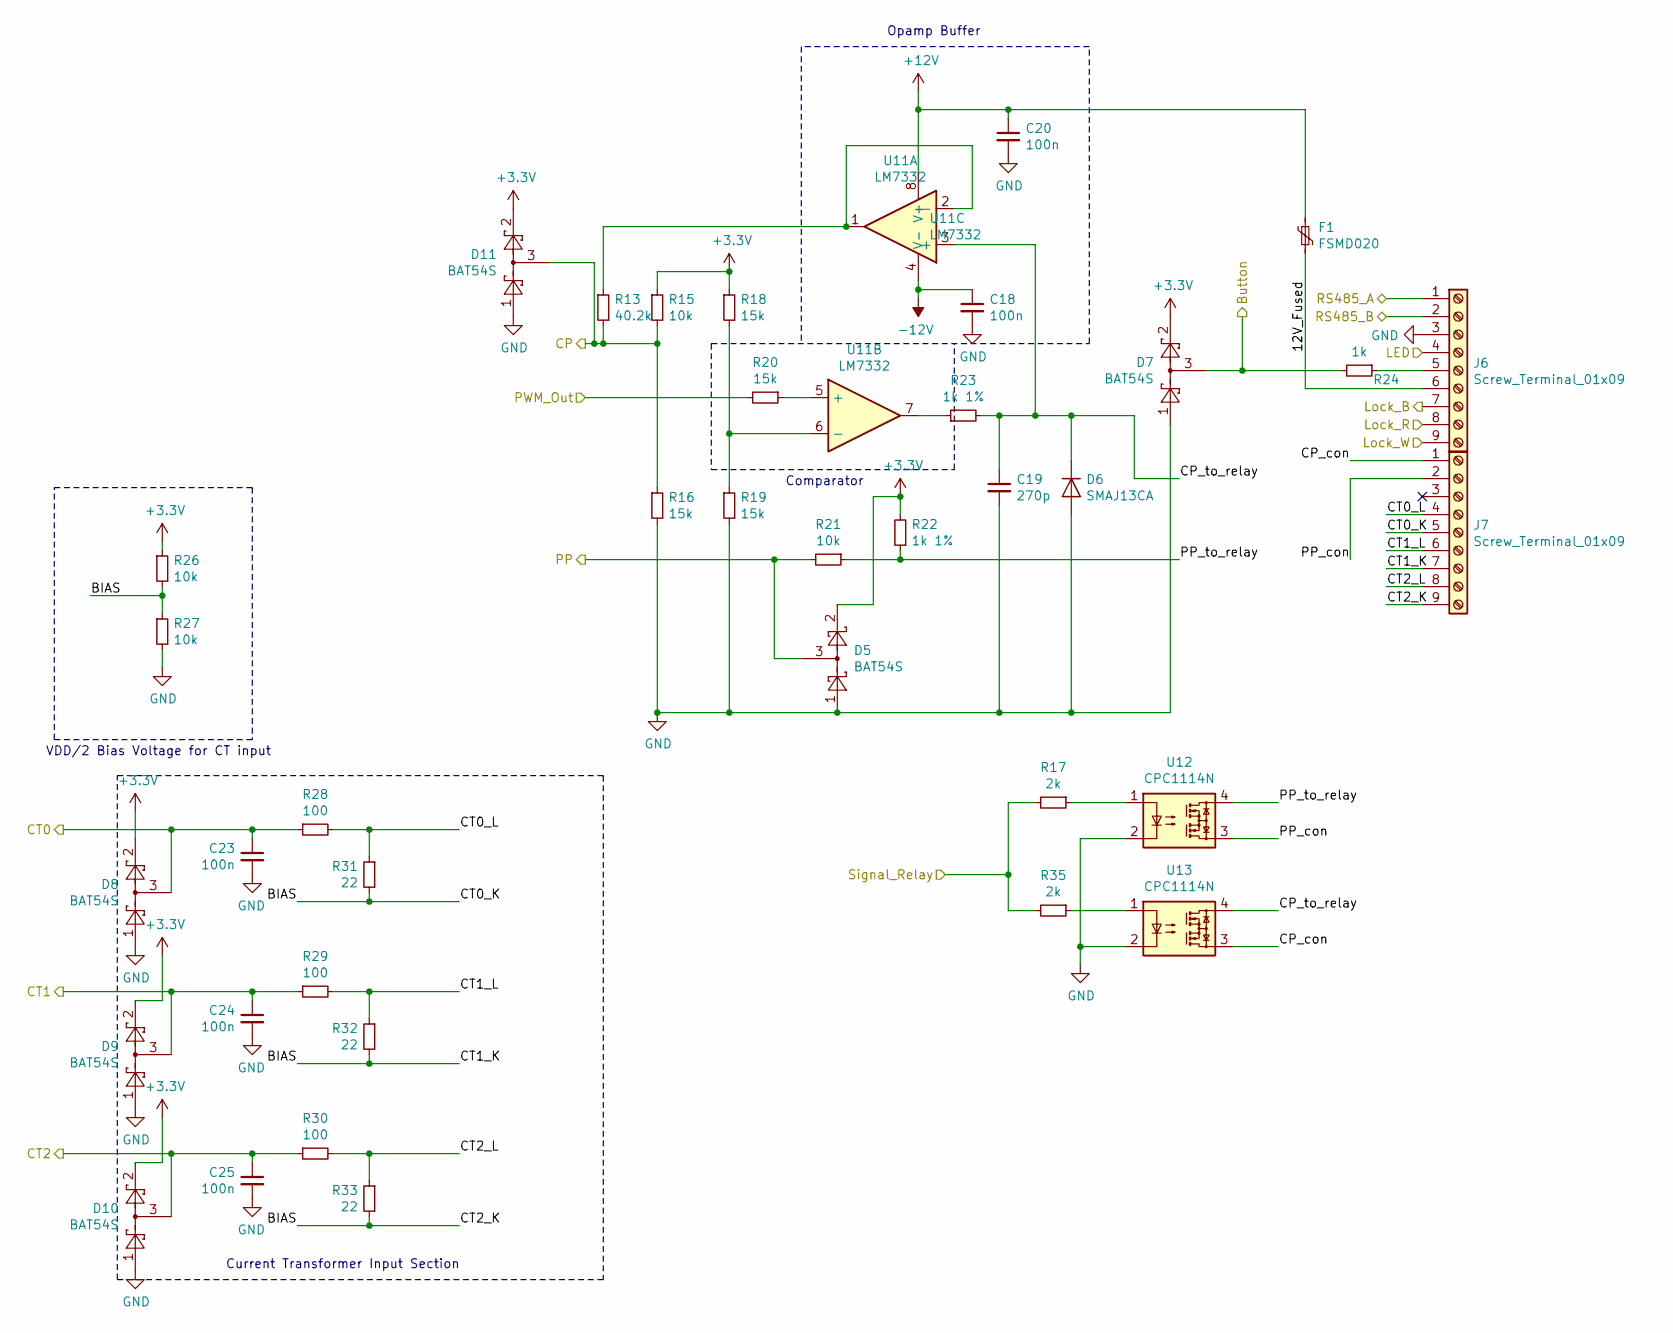
[picture p16: schematic analog_section_low_voltage.sch, FGCCS-Ctrl22]

Parts:
C18, C20, C23, C24, C25: 100n; C_0805_2012Metric_Pad1.15x1.40mm_HandSolder; PartNo 963-EMF212B7104KGHT
C19: 270p; C_0805_2012Metric_Pad1.15x1.40mm_HandSolder; PartNo 77-VJ0805A271KXJPBC
D5, D7: BAT54S; SOT-23_Handsoldering; PartNo 583-BAT54S
D6: SMAJ13CA; D_SMA_Handsoldering; PartNo 652-SMAJ13CA
D8, D9, D10, D11: BAT54S; SOT-23_Handsoldering
F1: FSMD020; Fuse_1812_4532Metric_Pad1.30x3.40mm_HandSolder; PartNo 576-1812L020PR
J6: Screw_Terminal_01x09; lv_screw_9pin_1
J7: Screw_Terminal_01x09; lv_screw_9pin_2
R13: 40.2k; R_0603_1608Metric_Pad1.05x0.95mm_HandSolder; PartNo 594-MCT06030C4022FP5
R15, R21, R26, R27: 10k; R_0603_1608Metric_Pad1.05x0.95mm_HandSolder; PartNo 594-MCT06030C1002FP5
R16, R18, R19, R20: 15k; R_0603_1608Metric_Pad1.05x0.95mm_HandSolder; PartNo 594-MCT06030C1502FP5
R17, R35: 2k; R_0603_1608Metric_Pad1.05x0.95mm_HandSolder; PartNo 594-MCT06030C2001FP5
R22, R23: 1k 1%; R_0603_1608Metric_Pad1.05x0.95mm_HandSolder; PartNo 594-MCT06030C1001FP5
R24: 1k; R_0603_1608Metric_Pad1.05x0.95mm_HandSolder; PartNo 594-MCT06030C1000FP5
R28, R29, R30: 100; R_0603_1608Metric_Pad1.05x0.95mm_HandSolder; PartNo 594-MCT06030C1000FP5
R31, R32, R33: 22; R_0603_1608Metric_Pad1.05x0.95mm_HandSolder; PartNo 594-MCT06030C2209FP5
U11: LM7332; SOIC-8_3.9x4.9mm_P1.27mm; PartNo 926-LM7332MA/NOPB
U12, U13: CPC1114N; SOP-4_3.8x4.1mm_P2.54mm; PartNo 849-CPC1114N

Connections:
+3V3: D5.2, D7.2, D8.2, D9.2, D10.2, D11.2, R15.1, R18.1, R22.2, R26.1; also elsewhere on the board
+12V: C20.1, F1.1, U11.8 (V+); also elsewhere on the board
-12V: C18.1, U11.4 (V-); also elsewhere on the board
/ATmega4808 and Peripherals/Button: D7.3, R24.2; also elsewhere on the board
/ATmega4808 and Peripherals/CP: D11.3, R13.2, R15.2, R16.1; also elsewhere on the board
/ATmega4808 and Peripherals/CT0: C23.1, D8.3, R28.1; also elsewhere on the board
/ATmega4808 and Peripherals/CT1: C24.1, D9.3, R29.1; also elsewhere on the board
/ATmega4808 and Peripherals/CT2: C25.1, D10.3, R30.1; also elsewhere on the board
/ATmega4808 and Peripherals/LED: J6.4; also elsewhere on the board
/ATmega4808 and Peripherals/Lock_B: J6.7; also elsewhere on the board
/ATmega4808 and Peripherals/Lock_R: J6.8; also elsewhere on the board
/ATmega4808 and Peripherals/Lock_W: J6.9; also elsewhere on the board
/ATmega4808 and Peripherals/PP: D5.3, R21.2; also elsewhere on the board
/ATmega4808 and Peripherals/PWM_Out: R20.2; also elsewhere on the board
/ATmega4808 and Peripherals/RS485_A: J6.1; also elsewhere on the board
/ATmega4808 and Peripherals/RS485_B: J6.2; also elsewhere on the board
/ATmega4808 and Peripherals/Signal_Relay: R17.2, R35.2; also elsewhere on the board
/Analog Section and Low Voltage Outputs/12V_Fused: F1.2, J6.6
/Analog Section and Low Voltage Outputs/BIAS: J7.5, J7.7, J7.9, R26.2, R27.1, R31.2, R32.2, R33.2
/Analog Section and Low Voltage Outputs/CP_con: J7.1, U13.3
/Analog Section and Low Voltage Outputs/CP_to_relay: C19.1, D6.1 (K), R23.2, U11.3 (+), U13.4
/Analog Section and Low Voltage Outputs/CT0_L: J7.4, R28.2, R31.1
/Analog Section and Low Voltage Outputs/CT1_L: J7.6, R29.2, R32.1
/Analog Section and Low Voltage Outputs/CT2_L: J7.8, R30.2, R33.1
/Analog Section and Low Voltage Outputs/PP_con: J7.2, U12.3
/Analog Section and Low Voltage Outputs/PP_to_relay: R21.1, R22.1, U12.4
GND: C18.2, C19.2, C20.2, C23.2, C24.2, C25.2, D5.1, D6.2 (A), D7.1, D8.1, D9.1, D10.1, D11.1, J6.3, R16.2, R19.2, R27.2, U12.2, U13.2; also elsewhere on the board
unnamed: J6.5, R24.1
unnamed: R13.1, U11.1, U11.2 (-)
unnamed: R17.1, U12.1
unnamed: R18.2, R19.1, U11.6 (-)
unnamed: R20.1, U11.5 (+)
unnamed: R23.1, U11.7
unnamed: R35.1, U13.1

Notes on the sheet:
Opamp Buffer
Comparator
Current Transformer Input Section
VDD/2 Bias Voltage for CT input

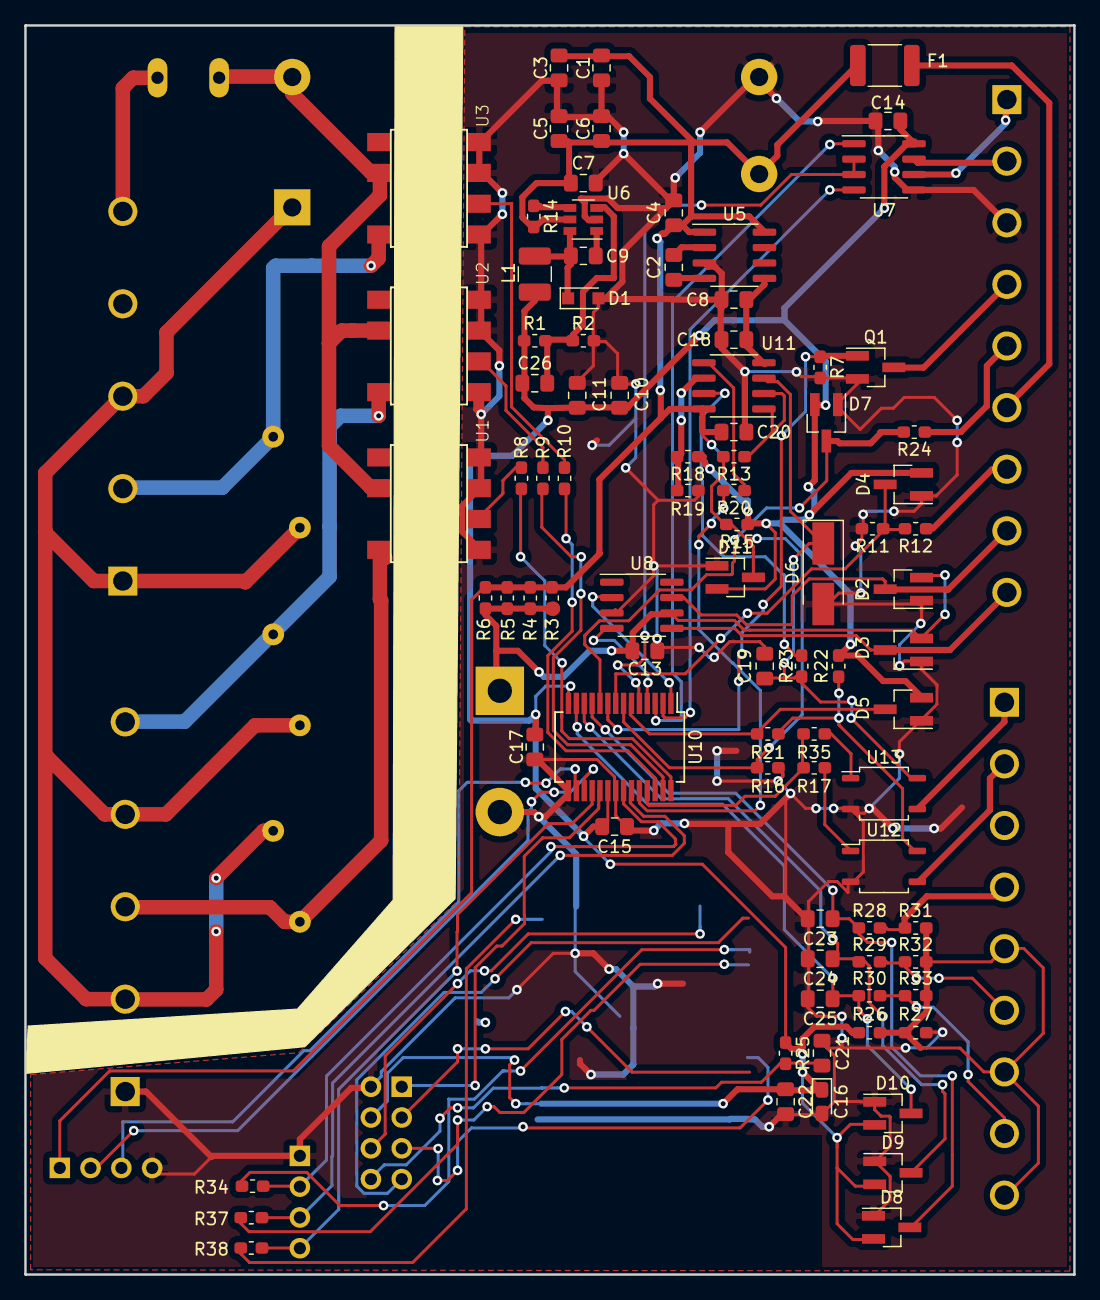
[picture p17: board fgccs-ctrl22.kicad_pcb from above]

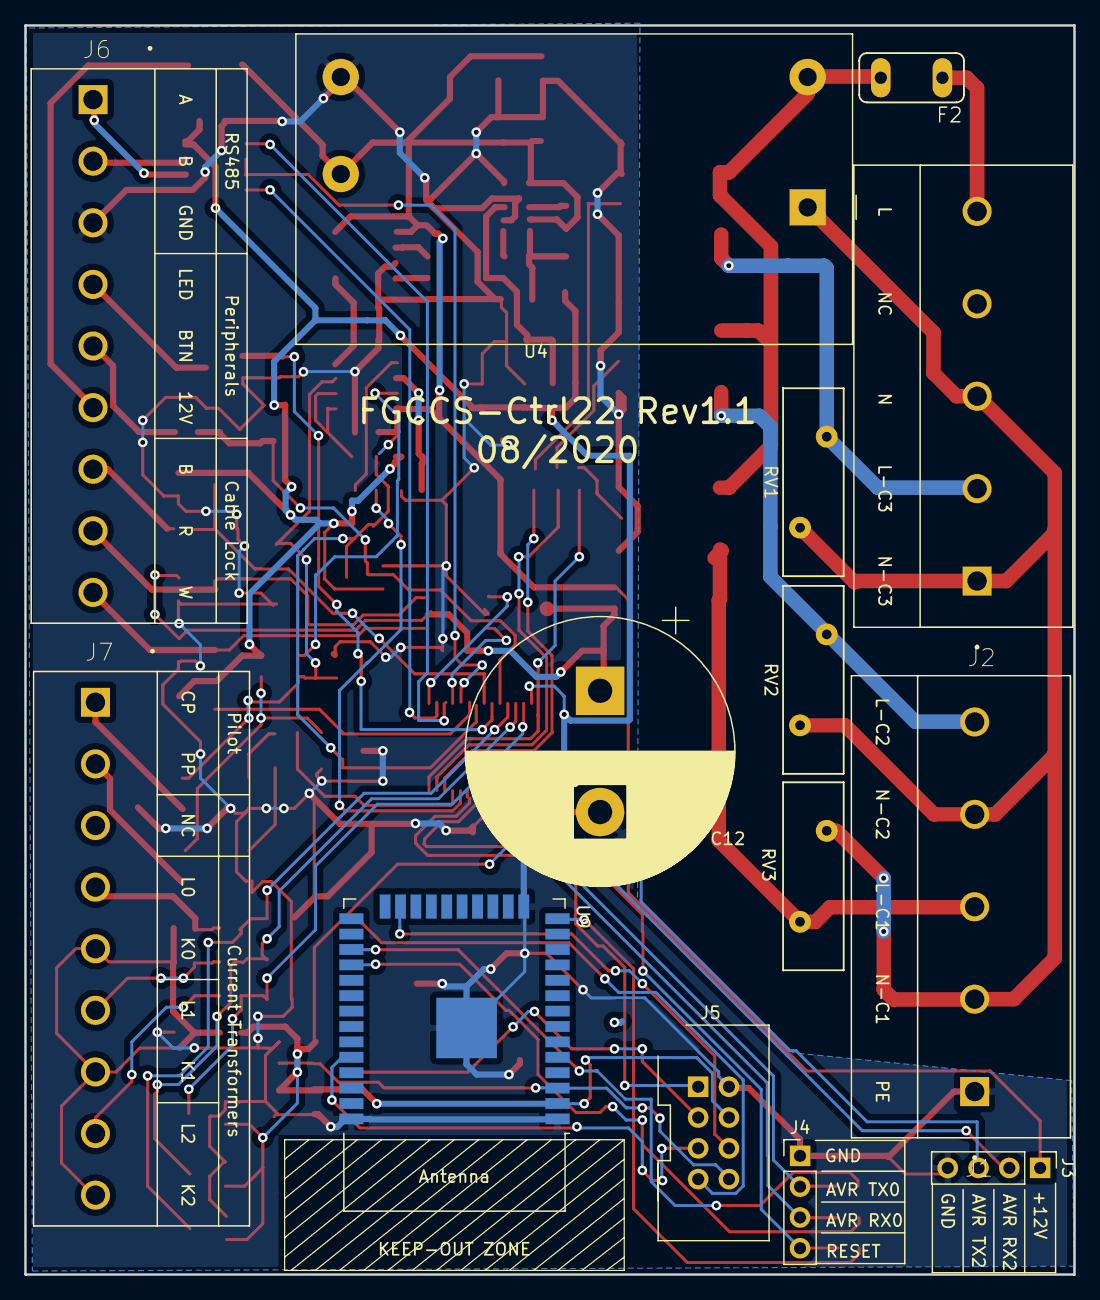
[picture p18: board fgccs-ctrl22.kicad_pcb from below]

Board: 2 copper layers, 86.5 x 103.0 mm, 101 parts (14 on the bottom side), 74 nets.
