dreadnomad/FGCCS-Ctrl22/(commit log)

2020-04-01 Collect datasheets for circuit design
2020-04-01 Collect information on circuit
    Note circuit functionality and pin config in SmartEVSE circuit diagram.
    This determines ATmega4808 config and aids in understanding the existing
    circuit components.
2020-04-03 Add ESP32 datasheet
2020-04-03 Add pin config tables to REVENG.md
2020-04-03 Complete SmartEVSE circuit analysis and update TODO
2020-04-06 Update REVENG.md with pin directions
2020-04-07 Import SmartEVSE schematic and layout into Kicad
    [SmartEVSEv2.2.kicad_pcb, SmartEVSEv2.2_kicad.sch]
2020-04-07 Add ATmega pin config v1
2020-04-08 Remove SmartEvse kicad project from repo
    [SmartEVSEv2.2.kicad_pcb, SmartEVSEv2.2_kicad.sch]
2020-04-08 Add initial kicad project for atmevse
    [atmevse_v1.kicad_pcb, atmevse_v1.sch]
2020-04-08 Add imported footprints from SmartEVSE project
2020-04-08 Capture mains and power supply schematics of atmevse_v1
    [atmevse_v1.sch]
2020-04-09 Change folder and project structure of kicad circuit data
    [atmevse.kicad_pcb, atmevse.sch]
2020-04-09 Continue schematic capture
    [atmega4808_and_peripherals.sch, atmevse.sch, mains_and_power.sch]
2020-04-10 Update to rev0.1 of atmevse circuit
    [analog_section_low_voltage.sch, atmega4808_and_peripherals.sch, atmevse.sch, mains_and_power.sch, qucs_ct_simulation.sch]
2020-04-10 remove qucs sim files
    [qucs_ct_simulation.sch]
2020-04-10 Update schematic to rev0.2
    [analog_section_low_voltage.sch, atmega4808_and_peripherals.sch, atmevse.sch, mains_and_power.sch]
2020-05-12 Update Schematic with Prof. Moor's suggestions
    [atmega4808_and_peripherals.sch, mains_and_power.sch]
2020-05-13 Add CT input simulation files
    [ct_simulation.sch]
2020-05-13 Update schematic with suggestions
    [analog_section_low_voltage.sch, atmega4808_and_peripherals.sch, atmevse.sch, mains_and_power.sch]
2020-05-14 Edit schematic
    Moved CT input to J2
    [analog_section_low_voltage.sch, atmevse.sch, mains_and_power.sch]
2020-05-14 Add simulation for 12V button circuit
    [button_simulation.sch]
2020-05-18 Update pin configuration
    All pins used now, PF0 & PF1 used for UART2
2020-05-18 Add simulation files for button w/o voltage divider
    Second simulation added for button input, which topology is better remains to be seen
    [button_simulation_no_div.sch]
2020-05-18 Update button simulation
    [button_simulation.sch]
2020-05-18 Edit schematic to rev0.6
    Updated schematic with ESP32, CT inputs moved, Button input circuit new.
    Temp sens removed, will use internal sensor in ATmega4808
    [analog_section_low_voltage.sch, atmega4808_and_peripherals.sch, atmevse.sch, mains_and_power.sch]
2020-05-18 First ATmega test program
    ATmega4808 & Atmel ICE UDPI programmer tested with LED-blinking program
2020-05-20 Update schematic
    Schematic updated with latest changes and preparation for footprint assignment
    [analog_section_low_voltage.sch, atmega4808_and_peripherals.sch]
2020-05-21 Add uart_test project
2020-05-28 Add new component data in schematic
    Updated components and footprints in schematic
    [analog_section_low_voltage.sch, atmega4808_and_peripherals.sch, mains_and_power.sch]
2020-05-29 Update Parts List with Mouser ordering info
    [analog_section_low_voltage.sch, atmega4808_and_peripherals.sch, atmevse.sch, mains_and_power.sch]
2020-06-01 Finish schematic rev1 and footprint assignment
    [analog_section_low_voltage.sch, atmega4808_and_peripherals.sch, atmevse.kicad_pcb, atmevse.sch, mains_and_power.sch, parts_mouser.xls]
2020-06-03 Update first layout draft
    [analog_section_low_voltage.sch, atmevse.kicad_pcb]
2020-06-10 Finish Rev1 PCB Layout and send off to fab
    PCB layout is done now, collect Revisions in REVISION.md
    TODO updated with current tasks
    [atmega4808_and_peripherals.sch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]
2020-06-15 Build optiboot for atmega4808
    [relay_sim.sch]
2020-06-23 Add arduino sketches and optiboot elf
    Arduino sketches for testing serial protocol
    Optiboot ELF for 4808 working
2020-06-30 Update revision list in REVISION.md
    first draft of ToC for documentation
    [j4-j5-pincfg.xlsx]
2020-07-29 Update locking functions
    [cp_input_sim.sch, hterm_cmd.cfg]
2020-08-06 Catchup commit.
    Hardware testing partially successful
    Interrupts not working
    [cmd.c, cmd.h, main.c, uart.c, uart.h]
2020-08-06 Test PWM level detection
2020-08-07 Rough main loop working
    Known bugs: uart drops chars...
    [uart.c, uart.h]
2020-08-14 Update doc
    [analog_section_low_voltage.sch, atmega4808_and_peripherals.sch, atmevse.sch, button_simulation_no_div.sch, cp-pp-input-diagram.sch, cp_input_sim.sch, konzept.sch, mains_and_power.sch]
2020-08-17 Testing build
    [analog_section_low_voltage.sch, atmega4808_and_peripherals.sch, atmevse.sch, cp-pp-input-diagram.sch, mains_and_power.sch, pp_input_sim.sch]
2020-08-24 Test interrupts
2020-08-24 Blink interrupt test
2020-08-25 Test implementation of current measurement
2020-08-27 Finish Revision 1.1 layout
    [analog_section_low_voltage.sch, atmega4808_and_peripherals.sch, atmevse.kicad_pcb]
2020-08-27 Pre-final commit
    [FGCCS-Ctrl22-Materialstueckliste.xls, analog_section_low_voltage.sch, atmega4808_and_peripherals.sch, atmevse.sch, cp_input_sim.sch, mains_and_power.sch]
2020-09-02 Cleaning up the repo
    [fgccs-ctrl22.kicad_pcb, fgccs-ctrl22.sch, hterm_cmd.cfg, konzept.sch]
2020-09-02 CLeaning up
    [hterm_cmd.cfg]
2020-09-02 Finish cleaning up
    TODO: Atmel Studio Project
    [hterm_cmd.cfg]
